besi/kicad-opb607a/screenshot.png

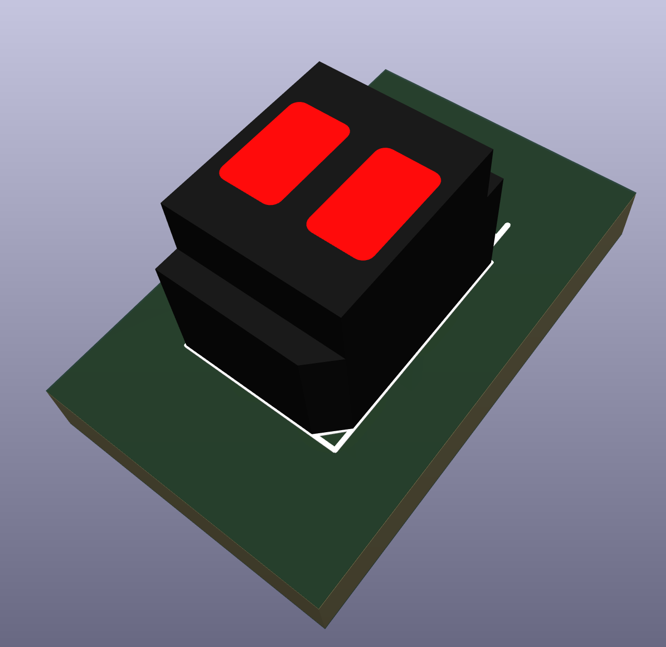
screenshot.png
