besi/kicad-opb607a/opb607a.step

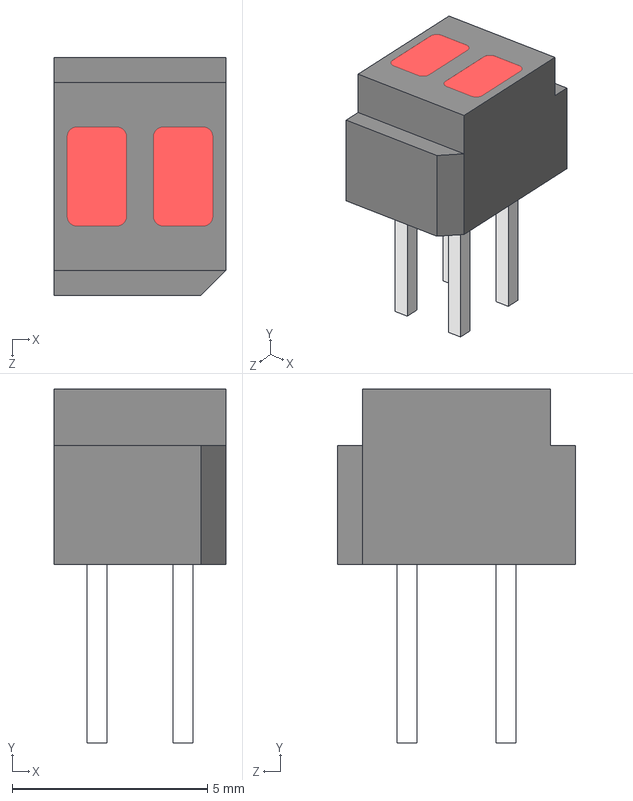
[picture p2: CAD file, 2023-12-04]
opb607a.step
4.39 x 9.07 x 6.10 mm
