besi/kicad-opb607a/(commit log)

2023-12-04 Add footprint
    [opb607a.step]
2023-12-12 Fix wrong pin numbering
